SeraphimlabsLLC/Dynamo/README.md

# Dynamo
DCC 4 channel booster

ESP32-S3 processor

optocoupled DCC input

4 channels motor shield output with current monitoring. auto reverse possible.
