SeraphimlabsLLC/Dynamo/Hardware/Dynamo/Dynamo.kicad_pcb

## KiCad design Hardware/Dynamo/Dynamo.kicad_pcb (2024-01-14)

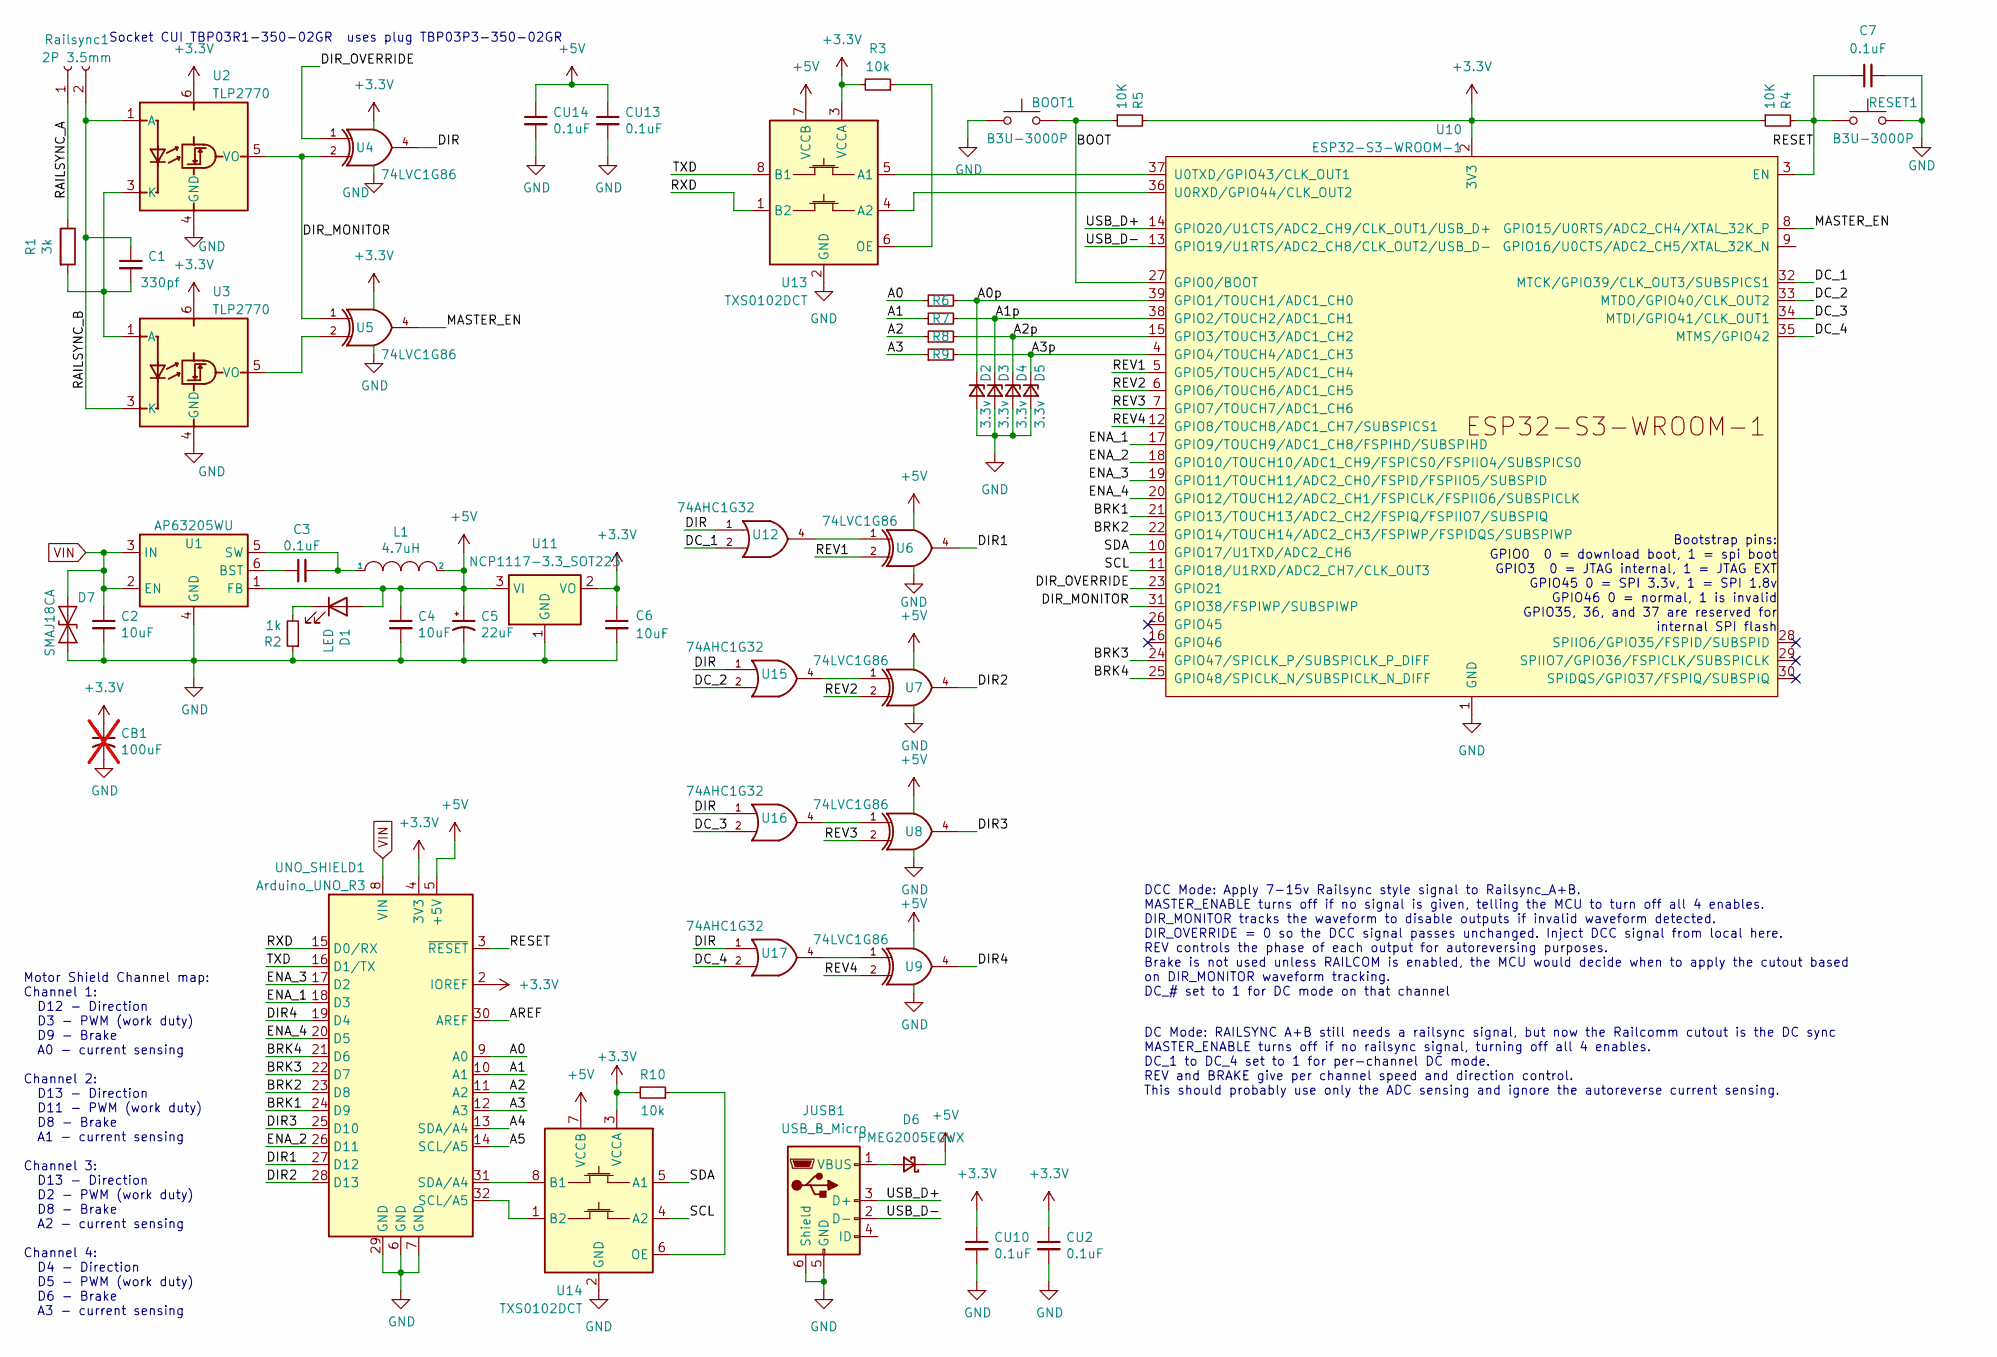
[picture p2: schematic Dynamo.kicad_sch, Dynamo - DCC 4 channel booster]

Parts:
BOOT1: B3U-3000P; SW_SPST_B3U-3000P-B; JLCPCB Part # C963349
C1: 330pf; C_1206_3216Metric; JLCPCB Part # C2223641
C2, C4, C6: 10uF; C_1210_3225Metric; JLCPCB Part # C2175202
C3, C7: 0.1uF; C_1206_3216Metric; JLCPCB Part # C600013
C5: 22uF; CP_Elec_5x5.3; JLCPCB Part # C2164091
CB1: 100uF; CP_Radial_D6.3mm_P2.50mm; not fitted
CU2, CU10, CU13, CU14: 0.1uF; C_1206_3216Metric; JLCPCB Part # C600013
D1: LED; LED_1206_3216Metric; JLCPCB Part # C7164018
D2, D3, D4, D5: 3.3v; D_SOD-123; JLCPCB Part # C151564
D6: PMEG2005EGWX; D_SOD-123; JLCPCB Part # C552812
D7: SMAJ18CA; D_SMA; JLCPCB Part # C523217
JUSB1: USB_B_Micro; USB_Micro-B_Molex-105017-0001; JLCPCB Part # C136000
L1: 4.7uH; L_Wurth_WE-LQSH-4020; JLCPCB Part # C2045329
R1: 3k; R_1206_3216Metric; JLCPCB Part # C132648
R2, R6, R7, R8, R9: 1k; R_1206_3216Metric; JLCPCB Part # C131398
R3, R10: 10k; R_1206_3216Metric; JLCPCB Part # C4303232
R4, R5: 10K; R_1206_3216Metric; JLCPCB Part # C4303232
RESET1: B3U-3000P; SW_SPST_B3U-3000P-B; JLCPCB Part # C963349
Railsync1: 2P 3.5mm; PhoenixContact_MC_1,5_2-G-3.5_1x02_P3.50mm_Horizontal; JLCPCB Part # C880572
U1: AP63205WU; TSOT-23-6; JLCPCB Part # C2071056
U2, U3: TLP2770; SO-6L_10x3.84mm_P1.27mm; JLCPCB Part # C150160
U4, U5, U6, U7, U8, U9: 74LVC1G86; SOT-23-5_HandSoldering; JLCPCB Part # C402161
U10: ESP32-S3-WROOM-1; JLCPCB Part # C2980298
U11: NCP1117-3.3_SOT223; SOT-223-3_TabPin2; JLCPCB Part # C91728
U12, U15, U16, U17: 74AHC1G32; SOT-23-5_HandSoldering; JLCPCB Part # C10096
U13, U14: TXS0102DCT; SSOP-8_2.95x2.8mm_P0.65mm; JLCPCB Part # C2677354
UNO_SHIELD1: Arduino_UNO_R3; Arduino_UNO_R3_WithMountingHoles

Connections:
+3.3V: C6.1, CB1.1, CU2.1, CU10.1, R3.2, R4.1, R5.2, R10.2, U2.6, U3.6, U4.5, U5.5, U10.2 (3V3), U11.2 (VO), U13.3 (VCCA), U14.3 (VCCA), UNO_SHIELD1.2 (IOREF), UNO_SHIELD1.4 (3V3)
+5V: C4.1, C5.1, CU13.1, CU14.1, D1.2 (A), D6.1 (K), L1.2, U1.1 (FB), U6.5 (VCC), U7.5 (VCC), U8.5 (VCC), U9.5 (VCC), U11.3 (VI), U12.5 (VCC), U13.7 (VCCB), U14.7 (VCCB), U15.5 (VCC), U16.5 (VCC), U17.5 (VCC), UNO_SHIELD1.5 (+5V)
/A0: R6.1, UNO_SHIELD1.9 (A0)
/A0p: D2.1 (K), R6.2, U10.39 (GPIO1/TOUCH1/ADC1_CH0)
/A1: R7.1, UNO_SHIELD1.10 (A1)
/A1p: D3.1 (K), R7.2, U10.38 (GPIO2/TOUCH2/ADC1_CH1)
/A2: R8.1, UNO_SHIELD1.11 (A2)
/A2p: D4.1 (K), R8.2, U10.15 (GPIO3/TOUCH3/ADC1_CH2)
/A3: R9.1, UNO_SHIELD1.12 (A3)
/A3p: D5.1 (K), R9.2, U10.4 (GPIO4/TOUCH4/ADC1_CH3)
/A4: UNO_SHIELD1.13 (SDA/A4)
/A5: UNO_SHIELD1.14 (SCL/A5)
/AREF: UNO_SHIELD1.30 (AREF)
/BOOT: BOOT1.1, R5.1, U10.27 (GPIO0/BOOT)
/BRK1: U10.21 (GPIO13/TOUCH13/ADC2_CH2/FSPIQ/FSPIIO7/S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), UNO_SHIELD1.24 (D9)
/BRK2: U10.22 (GPIO14/TOUCH14/ADC2_CH3/FSPIWP/FSPIDQS/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), UNO_SHIELD1.23 (D8)
/BRK3: U10.24 (GPIO47/SPICLK_P/SUBSPICLK_P_DIFF), UNO_SHIELD1.22 (D7)
/BRK4: U10.25 (GPIO48/SPICLK_N/SUBSPICLK_N_DIFF), UNO_SHIELD1.21 (D6)
/DC_1: U10.32 (MTCK/GPIO39/CLK_OUT3/SUBSPICS1), U12.2
/DC_2: U10.33 (MTDO/GPIO40/CLK_OUT2), U15.2
/DC_3: U10.34 (MTDI/GPIO41/CLK_OUT1), U16.2
/DC_4: U10.35 (MTMS/GPIO42), U17.2
/DIR: U4.4, U12.1, U15.1, U16.1, U17.1
/DIR1: U6.4, UNO_SHIELD1.27 (D12)
/DIR2: U7.4, UNO_SHIELD1.28 (D13)
/DIR3: U8.4, UNO_SHIELD1.25 (D10)
/DIR4: U9.4, UNO_SHIELD1.19 (D4)
/DIR_MONITOR: U2.5 (VO), U4.2, U5.1, U10.31 (GPIO38/FSPIWP/SUBSPIWP)
/DIR_OVERRIDE: U4.1, U10.23 (GPIO21)
/ENA_1: U10.17 (GPIO9/TOUCH9/ADC1_CH8/FSPIHD/SUBSPIHD), UNO_SHIELD1.18 (D3)
/ENA_2: U10.18 (GPIO10/TOUCH10/ADC1_CH9/FSPICS0/FSPIIO4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), UNO_SHIELD1.26 (D11)
/ENA_3: U10.19 (GPIO11/TOUCH11/ADC2_CH0/FSPID/FSPIIO5/S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), UNO_SHIELD1.17 (D2)
/ENA_4: U10.20 (GPIO12/TOUCH12/ADC2_CH1/FSPICLK/FSPIIO6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), UNO_SHIELD1.20 (D5)
/MASTER_EN: U5.4, U10.8 (GPIO15/U0RTS/ADC2_CH4/XTAL_32K_P)
/RAILSYNC_A: R1.1, Railsync1.1
/RAILSYNC_B: C1.1, Railsync1.2, U2.1 (A), U3.3 (K)
/RESET: C7.1, R4.2, RESET1.2, U10.3 (EN), UNO_SHIELD1.3 (~RESET)
/REV1: U6.2, U10.5 (GPIO5/TOUCH5/ADC1_CH4)
/REV2: U7.2, U10.6 (GPIO6/TOUCH6/ADC1_CH5)
/REV3: U8.2, U10.7 (GPIO7/TOUCH7/ADC1_CH6)
/REV4: U9.2, U10.12 (GPIO8/TOUCH8/ADC1_CH7/SUBSPICS1)
/RXD: U13.1 (B2), UNO_SHIELD1.15 (D0/RX)
/SCL: U10.11 (GPIO18/U1RXD/ADC2_CH7/CLK_OUT3), U14.4 (A2)
/SDA: U10.10 (GPIO17/U1TXD/ADC2_CH6), U14.5 (A1)
/TXD: U13.8 (B1), UNO_SHIELD1.16 (D1/TX)
/USB_D+: JUSB1.3 (D+), U10.14 (GPIO20/U1CTS/ADC2_CH9/CLK_OUT1/USB_D+)
/USB_D-: JUSB1.2 (D-), U10.13 (GPIO19/U1RTS/ADC2_CH8/CLK_OUT2/USB_D-)
GND: BOOT1.2, C2.2, C4.2, C5.2, C6.2, C7.2, CB1.2, CU2.2, CU10.2, CU13.2, CU14.2, D2.2 (A), D3.2 (A), D4.2 (A), D5.2 (A), D7.2 (A2), JUSB1.5 (GND), JUSB1.6 (Shield), R2.1, RESET1.1, U1.4 (GND), U2.4 (GND), U3.4 (GND), U4.3, U5.3, U6.3 (GND), U7.3 (GND), U8.3 (GND), U9.3 (GND), U10.1 (GND), U10.40 (GND), U10.41 (GND), U11.1 (GND), U12.3 (GND), U13.2 (GND), U14.2 (GND), U15.3 (GND), U16.3 (GND), U17.3 (GND), UNO_SHIELD1.6 (GND), UNO_SHIELD1.7 (GND), UNO_SHIELD1.29 (GND)
unnamed: D1.1 (K), R2.2
unnamed: D6.2 (A), JUSB1.1 (VBUS)
unnamed: C3.1, U1.6 (BST)
unnamed: C3.2, L1.1, U1.5 (SW)
unnamed: C1.2, R1.2, U2.3 (K), U3.1 (A)
unnamed: U3.5 (VO), U5.2
unnamed: U10.36 (U0RXD/GPIO44/CLK_OUT2), U13.4 (A2)
unnamed: U10.37 (U0TXD/GPIO43/CLK_OUT1), U13.5 (A1)
unnamed: U6.1, U12.4
unnamed: R3.1, U13.6 (OE)
unnamed: U14.8 (B1), UNO_SHIELD1.31 (SDA/A4)
unnamed: U14.1 (B2), UNO_SHIELD1.32 (SCL/A5)
unnamed: R10.1, U14.6 (OE)
unnamed: U7.1, U15.4
unnamed: U8.1, U16.4
unnamed: U9.1, U17.4
VIN: C2.1, D7.1 (A1), U1.2 (EN), U1.3 (IN), UNO_SHIELD1.8 (VIN)

Notes on the sheet:
Bootstrap pins: GPIO0 0 = download boot, 1 = spi boot GPIO3 0 = JTAG internal, 1 = JTAG EXT GPIO45 0 = SPI 3.3v, 1 = SPI 1.8v GPIO46 0 = normal, 1 is invalid GPIO35, 36, and 37 are reserved for internal SPI flash
DC Mode: RAILSYNC A+B still needs a railsync signal, but now the Railcomm cutout is the DC sync MASTER_ENABLE turns off if no railsync signal, turning off all 4 enables. DC_1 to DC_4 set to 1 for per-channel DC mode. REV and BRAKE give per channel speed and direction control. This should probably u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
Socket CUI TBP03R1-350-02GR uses plug TBP03P3-350-02GR
DCC Mode: Apply 7-15v Railsync style signal to Railsync_A+B. MASTER_ENABLE turns off if no signal is given, telling the MCU to turn off all 4 enables. DIR_MONITOR tracks the waveform to disable outputs if invalid waveform detected. DIR_OVERRIDE = 0 so the DCC signal passes unchanged. Inject DCC sig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
Motor Shield Channel map: Channel 1: D12 - Direction D3 - PWM (work duty) D9 - Brake A0 - current sensing Channel 2: D13 - Direction D11 - PWM (work duty) D8 - Brake A1 - current sensing Channel 3: D13 - Direction D2 - PWM (work duty) D8 - Brake A2 - current sensing Channel 4: D4 - Direction D5 - P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

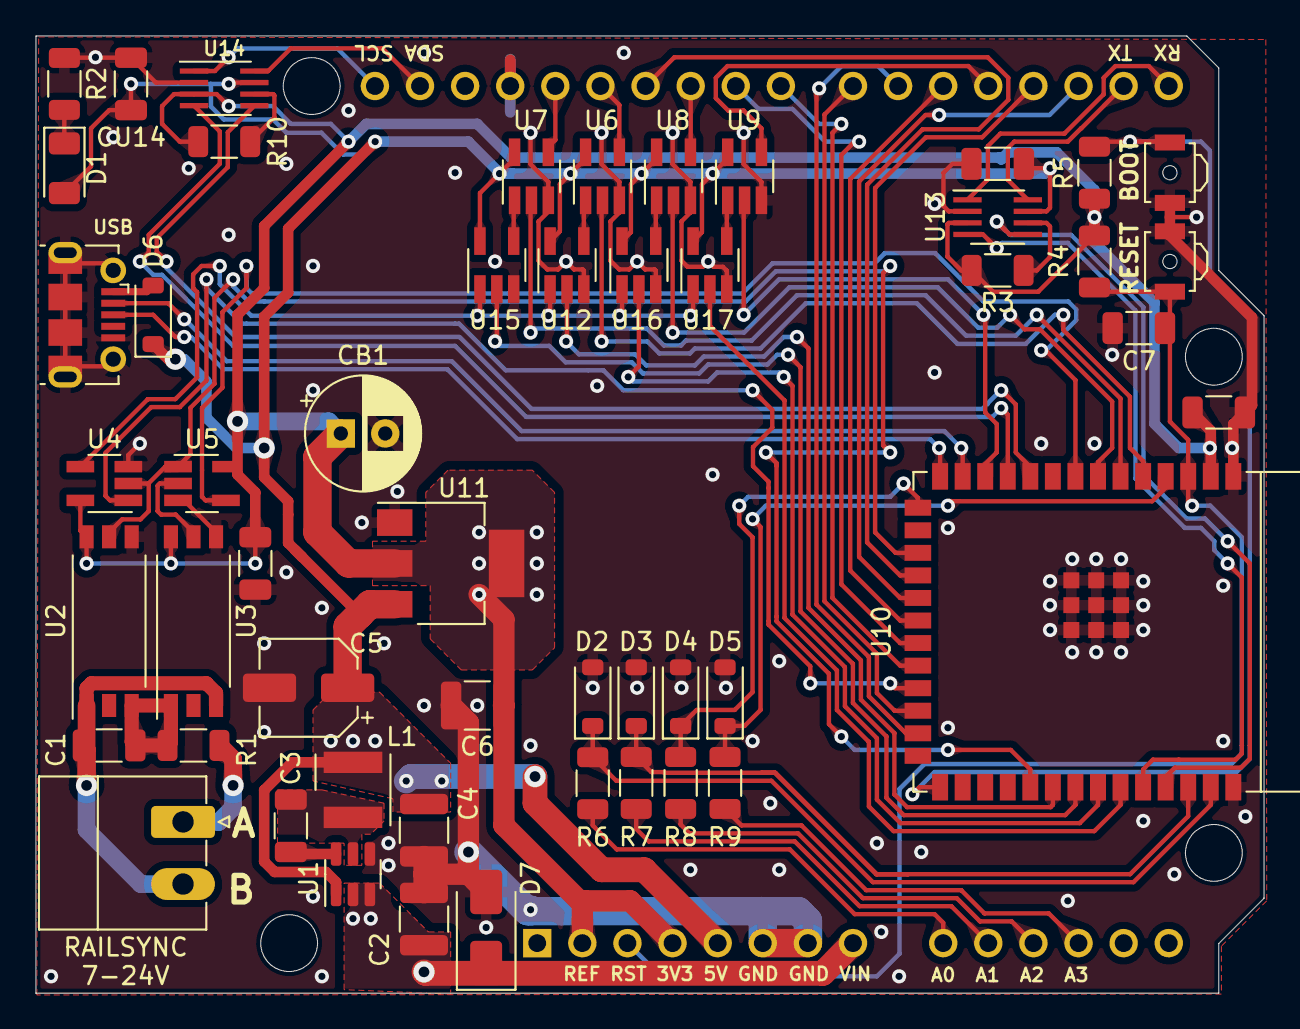
[picture p3: board Dynamo.kicad_pcb from above]

Board: 2 copper layers, 69.2 x 53.9 mm, 52 parts (1 on the bottom side), 62 nets.
