SeraphimlabsLLC/Dynamo/(commit log)

2023-07-27 Folder structure for hardware/software and KiCad solution
    [Dynamo.kicad_pcb, Dynamo.kicad_sch]
2023-07-30 Completed BOM, minor changes to schematic and PCB
    [Dynamo.kicad_pcb, Dynamo.kicad_sch]
2023-08-02 Fixed i2c_init, added rmt_rx_init and rmt_tx_init. Consider making a class arch( to hold all this HAL stuff
    [Dynamo.kicad_sch]
2023-08-20 Revised L1 for possible 2A output, cleaner fill zones, fabrication outputs
    [Dynamo-B_Cu.gbr, Dynamo-B_Mask.gbr, Dynamo-B_Paste.gbr, Dynamo-B_Silkscreen.gbr, Dynamo-Edge_Cuts.gbr, Dynamo-F_Cu.gbr, Dynamo-F_Mask.gbr, Dynamo-F_Paste.gbr]
2023-08-21 Added note about railsync terminal plug, BOM cleanup.
    [Dynamo.csv, Dynamo.kicad_sch]
2023-08-27 TrackChannel struct + extern in main working, MAX_TRACKS not accessible in main
    [Dynamo-B_Cu.gbr, Dynamo-B_Mask.gbr, Dynamo-B_Paste.gbr, Dynamo-B_Silkscreen.gbr, Dynamo-Edge_Cuts.gbr, Dynamo-F_Cu.gbr, Dynamo-F_Mask.gbr, Dynamo-F_Paste.gbr]
2023-08-27 Pin config situated. track configuration, powermode, and powerstate all written. Still needs the ADC and control signals written.
2023-09-28 Revert "First build using ESP AT Firmware 3.2"
    This reverts commit 2ba02e208466683df0494a767deb1f87a5861263.
    [Dynamo.ino, ESP32_Tracks_HW.cpp, ESP32_Tracks_HW.h]
2023-11-06 Assembled 1st board. Found Master Enable is too sensitive, the transition period between DCC pulses causes it to read 0 briefly.
    [Dynamo.csv]
2023-12-17 Schematic features changed: Added USB power for programming, per-track DC mode gating. New PCB layout improving on previous builds.
    [Dynamo.kicad_pcb, Dynamo.kicad_sch]
2023-12-17 Final cleanup, added tags for JLCPCB Fabrication
    [Dynamo.kicad_pcb]
2023-12-31 Recheck Schematic/PCB for inconsistencies
    [Dynamo-B_Cu.gbr, Dynamo-B_Mask.gbr, Dynamo-B_Paste.gbr, Dynamo-B_Silkscreen.gbr, Dynamo-Edge_Cuts.gbr, Dynamo-F_Cu.gbr, Dynamo-F_Mask.gbr, Dynamo-F_Paste.gbr]
2024-01-10 Change Railsync input to use same 3.5mm connector as EX8874 outputs
    [Dynamo-B_Cu.gbr, Dynamo-B_Mask.gbr, Dynamo-B_Paste.gbr, Dynamo-B_Silkscreen.gbr, Dynamo-Edge_Cuts.gbr, Dynamo-F_Cu.gbr, Dynamo-F_Mask.gbr, Dynamo-F_Paste.gbr]
2024-01-14 Revised 5v regulator, layout refinement.
    [Dynamo-B_Cu.gbr, Dynamo-B_Mask.gbr, Dynamo-B_Paste.gbr, Dynamo-B_Silkscreen.gbr, Dynamo-Edge_Cuts.gbr, Dynamo-F_Cu.gbr, Dynamo-F_Mask.gbr, Dynamo-F_Paste.gbr]
2024-01-30 BOM fix, replace NCP1117 with TLV1117
    [Dynamo.csv, Dynamo.kicad_sch]
